LiauBy/stm32-2axis-gimbal/docs/实物图.jpg

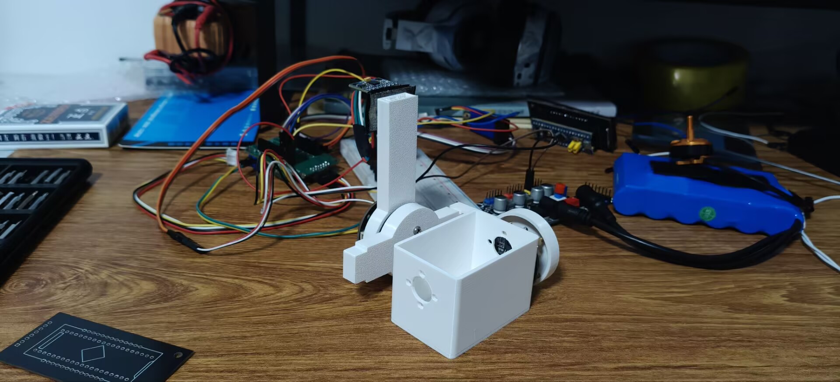
docs/实物图.jpg
