LiauBy/stm32-2axis-gimbal/mechanical/云台支架1.stl

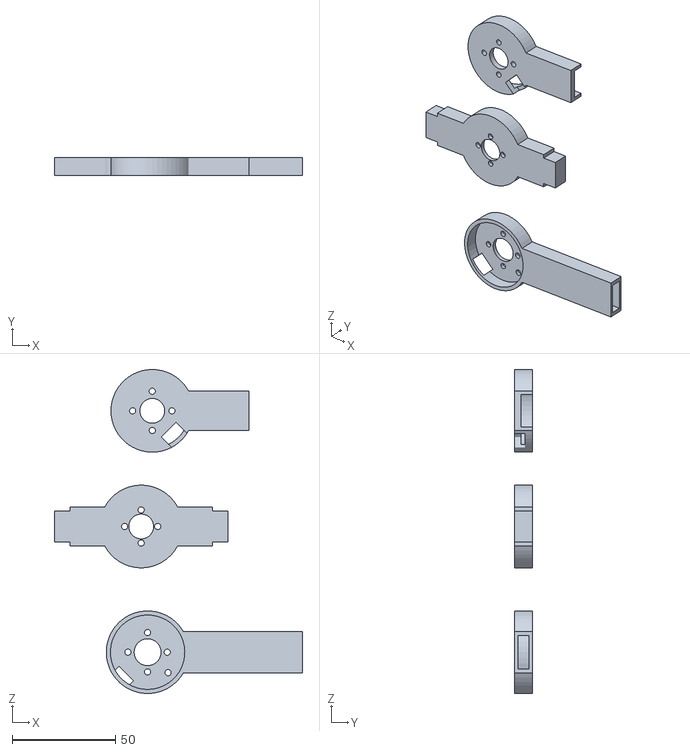
[picture p2: CAD file, 2026-10-16]
mechanical/云台支架1.stl
120.1 x 8.50 x 156.7
