LiauBy/stm32-2axis-gimbal/mechanical/云台支架3.stl

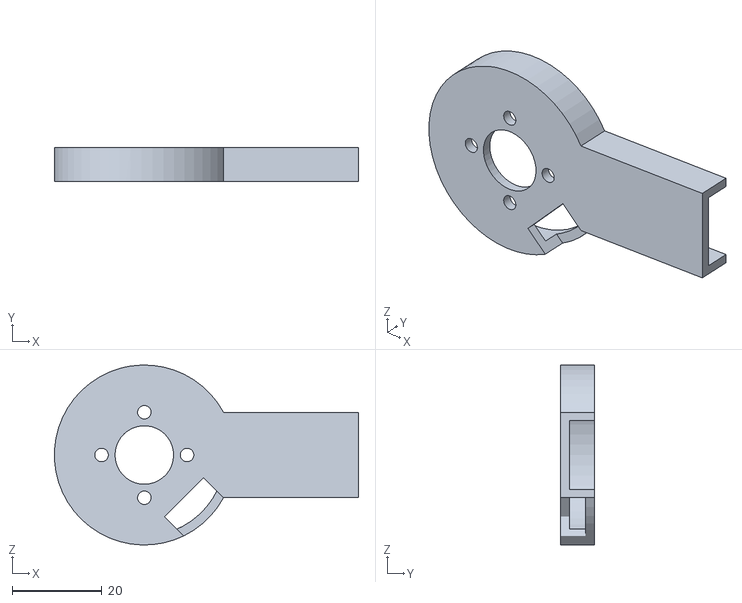
[picture p3: CAD file, 2026-10-16]
mechanical/云台支架3.stl
67.6 x 7.50 x 40.0
