LiauBy/stm32-2axis-gimbal/mechanical/云台支架2.stl

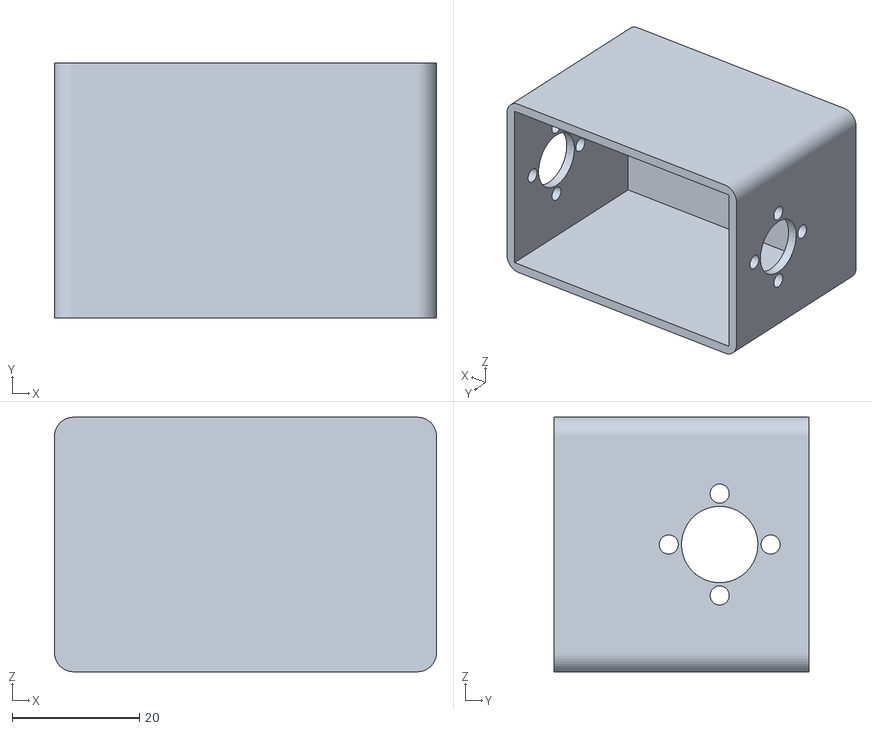
[picture p4: CAD file, 2026-10-16]
mechanical/云台支架2.stl
60.0 x 40.0 x 40.0
