LiauBy/stm32-2axis-gimbal/Hardware/PWM.c

#include "stm32f10x.h"  
#include "pwm.h"

void PWM_Init(void)
{
	TIM_TimeBaseInitTypeDef TIM_TimeBaseInitStructure;
	GPIO_InitTypeDef GPIO_InitStructure;
	TIM_OCInitTypeDef TIM_OCInitStructure;
	
	/*******选择内/外时钟源********/
	RCC_APB1PeriphClockCmd(RCC_APB1Periph_TIM2,ENABLE);
	RCC_APB1PeriphClockCmd(RCC_APB1Periph_TIM3,ENABLE);
	RCC_APB2PeriphClockCmd(RCC_APB2Periph_GPIOA,ENABLE);

	GPIO_InitStructure.GPIO_Mode = GPIO_Mode_AF_PP;
	GPIO_InitStructure.GPIO_Pin = GPIO_Pin_0|GPIO_Pin_1|GPIO_Pin_2|GPIO_Pin_3|GPIO_Pin_6|GPIO_Pin_7;
	GPIO_InitStructure.GPIO_Speed = GPIO_Speed_50MHz;
	GPIO_Init(GPIOA,&GPIO_InitStructure);
  /*********************************/
	
	/*******选择内部时钟********/
	TIM_InternalClockConfig(TIM2);
	TIM_InternalClockConfig(TIM3);
	
	/*******时基单元配置********/
	//TIM2
	TIM_TimeBaseInitStructure.TIM_ClockDivision = TIM_CKD_DIV1;
	TIM_TimeBaseInitStructure.TIM_CounterMode = TIM_CounterMode_Up;
	TIM_TimeBaseInitStructure.TIM_Period = 4800 - 1;
	TIM_TimeBaseInitStructure.TIM_Prescaler = 1 - 1;
	TIM_TimeBaseInitStructure.TIM_RepetitionCounter = 0;
	TIM_TimeBaseInit(TIM2, &TIM_TimeBaseInitStructure);
	
	TIM_OCStructInit(&TIM_OCInitStructure);
	TIM_OCInitStructure.TIM_OCMode = TIM_OCMode_PWM1;
	TIM_OCInitStructure.TIM_OCPolarity = TIM_OCPolarity_High;
	TIM_OCInitStructure.TIM_OutputState = TIM_OutputState_Enable;
	TIM_OCInitStructure.TIM_Pulse = 0;
	TIM_OC1Init(TIM2,&TIM_OCInitStructure);
	TIM_OC2Init(TIM2,&TIM_OCInitStructure);
	TIM_OC3Init(TIM2,&TIM_OCInitStructure);
	TIM_OC4Init(TIM2,&TIM_OCInitStructure);
	
	//TIM3
	TIM_TimeBaseInitStructure.TIM_ClockDivision = TIM_CKD_DIV1;
	TIM_TimeBaseInitStructure.TIM_CounterMode = TIM_CounterMode_Up;
	TIM_TimeBaseInitStructure.TIM_Period = 4800 - 1;
	TIM_TimeBaseInitStructure.TIM_Prescaler = 1 - 1;
	TIM_TimeBaseInitStructure.TIM_RepetitionCounter = 0;
	TIM_TimeBaseInit(TIM3, &TIM_TimeBaseInitStructure);
	
	TIM_OCStructInit(&TIM_OCInitStructure);
	TIM_OCInitStructure.TIM_OCMode = TIM_OCMode_PWM1;
	TIM_OCInitStructure.TIM_OCPolarity = TIM_OCPolarity_High;
	TIM_OCInitStructure.TIM_OutputState = TIM_OutputState_Enable;
	TIM_OCInitStructure.TIM_Pulse = 0;
	TIM_OC1Init(TIM3,&TIM_OCInitStructure);
	TIM_OC2Init(TIM3,&TIM_OCInitStructure);
	
	TIM_Cmd(TIM2, ENABLE);
	TIM_Cmd(TIM3, ENABLE);
}

void M0_PWM_A(float Compare)
{
	TIM_SetCompare1(TIM2, Compare);
}

void M0_PWM_B(float Compare)
{
	TIM_SetCompare2(TIM2, Compare);
}

void M0_PWM_C(float Compare)
{
	TIM_SetCompare3(TIM2, Compare);
}

void M1_PWM_A(float Compare)
{
	TIM_SetCompare4(TIM2, Compare);
}

void M1_PWM_B(float Compare)
{
	TIM_SetCompare1(TIM3, Compare);
}

void M1_PWM_C(float Compare)
{
	TIM_SetCompare2(TIM3, Compare);
}
