LiauBy/stm32-2axis-gimbal/System/Delay.h

#ifndef __DELAY_H
#define __DELAY_H

void Delay_us(uint32_t us);
void Delay_ms(uint32_t ms);
void Delay_s(uint32_t s);
void Systick_CountMode(void);
void delay_us(uint16_t time);
void delay_ms(uint16_t time);

#endif
