LiauBy/stm32-2axis-gimbal/System/Timer.c

#include "stm32f10x.h"                  // Device header

// ★ 独立看门狗初始化：LSI≈40kHz，预分频 /64 → 625Hz，重载 625 → 超时约 1s
//   （LSI 实际 30~60kHz，超时约 0.67~1.33s，主循环喂狗频率远高于此，留有余量）
void IWDG_Init(void)
{
	IWDG_WriteAccessCmd(IWDG_WriteAccess_Enable);
	IWDG_SetPrescaler(IWDG_Prescaler_64);
	IWDG_SetReload(625);
	IWDG_ReloadCounter();
	IWDG_Enable();					// 使能后不可关闭，必须周期性喂狗
}

// ★ 喂狗（主循环每轮调用）
void IWDG_Feed(void)
{
	IWDG_ReloadCounter();
}

void Timer_Init(void)
{
	RCC_APB2PeriphClockCmd(RCC_APB2Periph_TIM1, ENABLE);
	
	TIM_InternalClockConfig(TIM1);
	
	TIM_TimeBaseInitTypeDef TIM_TimeBaseInitStructure;
	TIM_TimeBaseInitStructure.TIM_ClockDivision = TIM_CKD_DIV1;
	TIM_TimeBaseInitStructure.TIM_CounterMode = TIM_CounterMode_Up;
	TIM_TimeBaseInitStructure.TIM_Period = 1000 - 1;
	TIM_TimeBaseInitStructure.TIM_Prescaler = 72 - 1;
	TIM_TimeBaseInitStructure.TIM_RepetitionCounter = 0;
	TIM_TimeBaseInit(TIM1, &TIM_TimeBaseInitStructure);
	
	TIM_ClearFlag(TIM1, TIM_FLAG_Update);
	TIM_ITConfig(TIM1, TIM_IT_Update, ENABLE);
	
	NVIC_PriorityGroupConfig(NVIC_PriorityGroup_2);
	
	NVIC_InitTypeDef NVIC_InitStructure;
	NVIC_InitStructure.NVIC_IRQChannel = TIM1_UP_IRQn;
	NVIC_InitStructure.NVIC_IRQChannelCmd = ENABLE;
	NVIC_InitStructure.NVIC_IRQChannelPreemptionPriority = 2;
	NVIC_InitStructure.NVIC_IRQChannelSubPriority = 1;
	NVIC_Init(&NVIC_InitStructure);
	
	TIM_Cmd(TIM1, ENABLE);
}

/*
void TIM1_UP_IRQHandler(void)
{
	if (TIM_GetITStatus(TIM1, TIM_IT_Update) == SET)
	{
		
		TIM_ClearITPendingBit(TIM1, TIM_IT_Update);
	}
}
*/
