LiauBy/stm32-2axis-gimbal/(commit log)

2026-10-16 feat: STM32F103 二轴自稳云台 — Mahony 姿态解算 + FOC 电压矢量调制
    - Mahony 四元数互补滤波姿态解算（IMU.c）
    - FOC 电压矢量调制：逆 Park/Clarke、电角度计算、软启动斜坡（DFOC.c）
    - AS5600 磁编码器电角度对齐 + 上电参考零点捕获（防缠线）
    - 位置环 PID + 陀螺速率阻尼，10 ms 控制周期
    - 传感器故障锁存停机 + IWDG 看门狗 + 上电自检
    - 串口定点浮点打印与 CSV 调参输出（高优先级中断防丢字节）
    - 结构件：SOLIDWORKS 设计 + 3D 打印（mechanical/）
    已知限制见 README：无电流环、控制周期 10 ms、无磁力计。MIT License.
2026-10-16 docs: 补充合作背景说明，修正素材说明的单数表述
    - 新增「关于本项目」：说明为两人合作开发，本仓库为其中一位开发者维护的版本
    - 「作者自行拍摄」→「本项目自行拍摄」（原表述为单数，与事实不符）
